Delresearch/WhisperTrack-Hardware/BOM/094-0098-00.xlsx

Part Number | Quantity | Reference Designator | Value | Description | AML Status | Manufacturer | Manufacturer Part
000-0000-00 | 25 | C25,C27,C53,C55,C75,D15,J5,J6,J7,J8,J9,J10,J11,R35,R46,R50,R52,R68,R77,R83,TP1,TP2,TP3,TP4,TP5 |  | DO NOT POPULATE
013-0143-00 | 2 | U5,U11 | SN74LVC2T45 | IC TRNSLTR BIDIRECTIONAL US8 | Preliminary | Texas Instruments | SN74LVC2T45DCUR
 |  |  |  |  | Preliminary | Texas Instruments | SN74LVC2T45DCUT
 |  |  |  |  | Preliminary | Nexperia USA Inc. | 74LVC2T45DC,125
013-0183-00 | 2 | U7,U14 | LMR36503MSCQRPERQ1 | AUTOMOTIVE 3-V TO 65-V, 0.3-A BU | Preliminary | Texas Instruments | LMR36503MSCQRPERQ1
013-0301-00 | 1 | U13 | SN74LVC2G86DCTR | IC GATE XOR 2CH 2-INP SM8 | Preliminary | Texas Instruments | SN74LVC2G86DCTR
013-0302-00 | 2 | U3,U4 | NCP51513ABMNTWG | 130V, 2.5/3.0A HIGH AND LOW SIDE | Preliminary | ON Semiconductor | NCP51513ABMNTWG
013-0305-00 | 1 | U18 | LM5156 | 2.2-MHZ WIDE VIN NONSYNCHRONOUS | Preliminary | Texas Instruments | LM5156DSSR
013-0319-00 | 1 | U17 | STM32L496VGT6P | IC MCU 32BIT 1MB FLASH 100LQFP | Preliminary | STMicroelectronics | STM32L496VGT6P
013-0320-00 | 1 | U12 | TPS7A20185PDBVR | IC REG LIN 1.85V 300MA SOT23-5 | Preliminary | Texas Instruments | TPS7A20185PDBVR
013-0322-00 | 1 | U9 | TLV709A50DBVR | 150-MA 30-V LOW-DROPOUT (LDO) LI | Preliminary | Texas Instruments | TLV709A50DBVR
013-0323-00 | 1 | U2 | TLV709A33DBVR | 150-MA 30-V LOW-DROPOUT (LDO) LI | Preliminary | Texas Instruments | TLV709A33DBVR
013-0326-00 | 1 | U19 | INA350CDSIDDFR | TINY (2-MM 2-MM), LOW-POWER (100 | Preliminary | Texas Instruments | INA350CDSIDDFR
013-0327-00 | 1 | Q6 | ZXMS6004N8-13 | IC PWR DRIVER N-CHANNEL 1:1 8SO | Preliminary | Diodes Incorporated | ZXMS6004N8-13
013-0360-00 | 1 | U6 | MCP6007 | IC OPAMP GP 2 CIRCUIT 8MSOP | Preliminary | Microchip Technology | MCP6007T-E/MS
 |  |  |  |  | Preliminary | Microchip Technology | MCP6007-E/MS
013-0361-00 | 1 | U10 | PS07-S160MP-6P | SENSOR 2320PSIS .15V | Preliminary | Same Sky | PS07-S160MP-6P
013-0362-00 | 1 | U1 | MCP3561RT-E/NC | IC ADC 24BIT SIGMA-DELTA 20UQFN | Preliminary | Microchip Technology | MCP3561RT-E/NC
013-0363-00 | 1 | U15 | TPS628437DRLR | IC REG BUCK PROG 600MA SOT563 | Preliminary | Texas Instruments | TPS628437DRLR
013-0364-00 | 1 | U16 | TPS22925CN | IC PWR SWITCH N-CHAN 1:1 6DSBGA | Preliminary | Texas Instruments | TPS22925CNYPHR
 |  |  |  |  | Preliminary | Texas Instruments | TPS22925CNYPHT
018-0001-00 | 7 | R1,R2,R4,R42,R54,R66,R69 | 10k/0402 | RES SMD 10K OHM 1% 1/16W 0402 | Preliminary | Yageo | RC0402FR-0710KL
 |  |  |  |  | Preliminary | Vishay Dale | CRCW040210K0FKED
018-0008-00 | 3 | R10,R11,R58 | 1k/0402 | RES SMD 1K OHM 1% 1/16W 0402 | Preliminary | Yageo | RC0402FR-071KL
 |  |  |  |  | Preliminary | Vishay Dale | CRCW04021K00FKED
018-0009-00 | 1 | R78 | 100/0402 | RES SMD 100 OHM 1% 1/16W 0402 | Preliminary | Yageo | RC0402FR-07100RL
 |  |  |  |  | Preliminary | Vishay Dale | CRCW0402100RFKED
018-0010-00 | 4 | R51,R53,R59,R60 | 33.2/0402 | RES SMD 33.2 OHM 1% 1/16W 0402 | Preliminary | Yageo | RC0402FR-0733R2L
 |  |  |  |  | Preliminary | Vishay Dale | CRCW040233R2FKED
018-0018-00 | 18 | R7,R39,R41,R43,R61,R63,R64,R67,R72,R75,R76,R79,R80,R82,R84,R95,R96,R98 | 0/0402 | RES SMD 0 OHM JUMPER 1/16W 0402 | Preliminary | Yageo | RC0402JR-070RL
 |  |  |  |  | Preliminary | Vishay Dale | CRCW04020000Z0ED
018-0020-00 | 18 | R5,R9,R12,R19,R23,R25,R34,R44,R45,R48,R49,R55,R56,R57,R65,R73,R94,R99 | 100k/0402 | RES SMD 100K OHM 1% 1/16W 0402 | Preliminary | Yageo | RC0402FR-07100KL
 |  |  |  |  | Preliminary | Vishay Dale | CRCW0402100KFKED
018-0041-00 | 1 | R97 | 10/0402 | RES SMD 10 OHM 1% 1/16W 0402 | Preliminary | Yageo | RC0402FR-0710RL
 |  |  |  |  | Preliminary | Panasonic Electronic Components | ERJ-2RKF10R0X
018-0043-00 | 1 | R47 | 11k/0402 | RES SMD 11K OHM 1% 1/16W 0402 | Preliminary | Yageo | RC0402FR-0711KL
 |  |  |  |  | Preliminary | Samsung Electro-Mechanics | RC1005F113CS
018-0094-00 | 1 | R85 | 59k/0402 | RES SMD 59K OHM 1% 1/16W 0402 | Preliminary | Stackpole Electronics Inc | RMCF0402FT59K0
 |  |  |  |  | Preliminary | Yageo | RC0402FR-0759KL
018-0100-00 | 1 | R81 | 5.11k/0402 | RES SMD 5.11K OHM 1% 1/16W 0402 | Preliminary | Yageo | RC0402FR-075K11L
 |  |  |  |  | Preliminary | Vishay Dale | CRCW04025K11FKEDC
018-0181-00 | 4 | R17,R21,R28,R32 | 22.1k/0603 | RES SMD 22.1K OHM 1% 1/10W 0603 | Preliminary | Stackpole Electronics Inc | RMCF0603FT22K1
 |  |  |  |  | Preliminary | Yageo | RC0603FR-0722K1L
018-0183-00 | 4 | R15,R20,R29,R30 | 0/0603 | RES SMD 0 OHM JUMPER 1/10W 0603 | Preliminary | Yageo | RC0603JR-070RP
 |  |  |  |  | Preliminary | Stackpole Electronics Inc | RMCF0603ZT0R00
018-0227-00 | 1 | R86 | 332k/0402 | RES SMD 332K OHM 1% 1/16W 0402 | Preliminary | Stackpole Electronics Inc | RMCF0402FT332K
 |  |  |  |  | Preliminary | Yageo | RC0402FR-07332KL
018-0256-00 | 2 | R90,R91 | 18.7k/0402 | RES SMD 18.7K OHM 1% 1/16W 0402 | Preliminary | Yageo | RC0402FR-0718K7L
 |  |  |  |  | Preliminary | Stackpole Electronics Inc | RMCF0402FT18K7
018-0264-00 | 1 | R88 | 21.5k/0402 | RES SMD 21.5K OHM 1% 1/16W 0402 | Preliminary | Stackpole Electronics Inc | RMCF0402FT21K5
 |  |  |  |  | Preliminary | Yageo | RC0402FR-0721K5L
018-0283-00 | 4 | R3,R8,R33,R89 | 221k/0402 | RES SMD 221K OHM 1% 1/16W 0402 | Preliminary | Yageo | RC0402FR-07221KL
 |  |  |  |  | Preliminary | Stackpole Electronics Inc | RMCF0402FT221K
018-0312-00 | 2 | R92,R100 | 200k/1206 | RES SMD 200K OHM 1% 1/4W 1206 | Preliminary | Yageo | RC1206FR-07200KL
 |  |  |  |  | Preliminary | Stackpole Electronics Inc | RMCF1206FT200K
018-0314-00 | 3 | R37,R40,R70 | 100k/0402/0.1% | RES SMD 100K OHM 0.1% 1/16W 0402 | Preliminary | Yageo | RT0402BRD07100KL
 |  |  |  |  | Preliminary | Panasonic Electronic Components | ERA-2AEB104X
018-0315-00 | 1 | R71 | 105k/0402/0.1% | RES SMD 105K OHM 0.1% 1/16W 0402 | Preliminary | Yageo | RT0402BRD07105KL
 |  |  |  |  | Preliminary | TE Connectivity Passive Product | CPF0402B105KE1
018-0316-00 | 1 | R62 | 0.018/2512 | RES 0.018 OHM 1% 3W 2512 | Preliminary | TE Connectivity Passive Product | TLRP3A30DR018FTE
 |  |  |  |  | Preliminary | Eaton - Electronics Division | MSMA2512R0180FGN
018-0317-00 | 1 | R87 | 9.53k/0402 | RES SMD 9.53K OHM 1% 1/16W 0402 | Preliminary | Yageo | RC0402FR-079K53L
 |  |  |  |  | Preliminary | Stackpole Electronics Inc | RMCF0402FT9K53
018-0320-00 | 2 | R93,R101 | 20k/1206/0.5W | RES 20K OHM 1% 1/2W 1206 | Preliminary | Stackpole Electronics Inc | RNCP1206FTD20K0
 |  |  |  |  | Preliminary | Vishay Dale | RCC120620K0FKEA
 |  |  |  |  | Preliminary | Vishay Dale | RCS120620K0FKEA
018-0334-00 | 1 | R36 | 12.4k/0402/0.1% | RES SMD 12.4KOHM 0.1% 1/16W 0402 | Preliminary | Panasonic Electronic Components | ERA-2AEB1242X
 |  |  |  |  | Preliminary | Susumu | RG1005P-1242-B-T5
018-0335-00 | 1 | R38 | 6.19k/0402/0.1% | RES SMD 6.19KOHM 0.1% 1/16W 0402 | Preliminary | Panasonic Electronic Components | ERA-2AEB6191X
 |  |  |  |  | Preliminary | Yageo | RT0402BRE076K19L
018-0336-00 | 4 | R16,R18,R26,R31 | 6.8/0603 | RES SMD 6.8 OHM 1% 1/10W 0603 | Preliminary | Yageo | RC0603FR-136R8L
 |  |  |  |  | Preliminary | Stackpole Electronics Inc | RMCF0603FT6R80
018-0337-00 | 6 | R6,R13,R14,R22,R24,R27 | 2/0603 | RES SMD 2 OHM 1% 1/10W 0603 | Preliminary | Yageo | RC0603FR-072RL
 |  |  |  |  | Preliminary | Stackpole Electronics Inc | RMCF0603FT2R00
018-0338-00 | 1 | R74 | 44.2k/0402 | RES SMD 44.2K OHM 1% 1/16W 0402 | Preliminary | Yageo | RC0402FR-0744K2L
 |  |  |  |  | Preliminary | Stackpole Electronics Inc | RMCF0402FT44K2
020-0002-00 | 5 | C4,C16,C31,C40,C47 | 0.1uF/50V/X7R/0603 | CAP CER 0.1UF 50V X7R 0603 | Preliminary | KEMET | C0603C104K5RACTU
 |  |  |  |  | Preliminary | Samsung Electro-Mechanics | CL10B104KB8NNNC
020-0008-00 | 2 | C9,C13 | 10uF/35V/X7R/1206 | CAP CER 10UF 35V X7R 1206 | Preliminary | Taiyo Yuden | GMK316AB7106KL-TR
 |  |  |  |  | Preliminary | TDK Corporation | CGA5L1X7R1V106K160AC
020-0012-00 | 1 | C34 | 4.7uF/16V/X7R/0805 | CAP CER 4.7UF 16V X7R 0805 | Preliminary | KEMET | C0805C475K4RACTU
 |  |  |  |  | Preliminary | Samsung Electro-Mechanics | CL21B475KOFNFNE
020-0013-00 | 1 | C67 | 100pF/50V/C0G/0402 | CAP CER 100PF 50V C0G/NP0 0402 | Preliminary | Murata Electronics | GRM1555C1H101JA01D
 |  |  |  |  | Preliminary | Samsung Electro-Mechanics | CL05C101JB5NNNC
020-0024-00 | 2 | C32,C41 | 10uF/50V/X5R/1206 | CAP CER 10UF 50V X5R 1206 | Preliminary | Taiyo Yuden | UMK316BBJ106ML-T
 |  |  |  |  | Preliminary | TDK Corporation | CGA5L3X5R1H106M160AB
020-0035-00 | 1 | C80 | 0.22uF/25V/X7R/0603 | CAP CER 0.22UF 25V X7R 0603 | Preliminary | KEMET | C0603C224K3RACAUTO
 |  |  |  |  | Preliminary | Würth Elektronik | 885012206073
020-0048-00 | 1 | C71 | 2.2uF/16V/X5R/0603 | CAP CER 2.2UF 16V X5R 0603 | Preliminary | Taiyo Yuden | EMK107ABJ225KAHT
 |  |  |  |  | Preliminary | Samsung Electro-Mechanics | CL10A225KO8NNNC
020-0057-00 | 5 | C21,C23,C56,C70,C83 | 1000pF/50V/C0G/0402/1% | CAP CER 1000PF 50V C0G/NP0 0402 | Preliminary | Murata Electronics | GRM1555C1H102FA01D
 |  |  |  |  | Preliminary | Murata Electronics | GRM1555C1H102FA01J
020-0074-00 | 29 | C1,C2,C3,C7,C8,C10,C18,C19,C22,C24,C30,C33,C35,C36,C37,C43,C46,C51,C57,C59,C65,C74,C76,C79,C81,C84,C85,C87,C88 | 0.1uF/25V/X7R/0402 | CAP CER 0.1UF 25V X7R 0402 | Preliminary | Murata Electronics | GRM155R71E104KE14J
 |  |  |  |  | Preliminary | Yageo | CC0402KRX7R8BB104
020-0075-00 | 3 | C12,C17,C48 | 0.1uF/100V/X7R/0603 | CAP CER 0.1UF 100V X7R 0603 | Preliminary | Samsung Electro-Mechanics | CL10B104KC8NNNC
 |  |  |  |  | Preliminary | Yageo | CC0603KRX7R0BB104
020-0077-00 | 4 | C14,C15,C38,C39 | 2.2uF/100V/X7R/1210 | CAP CER 2.2UF 100V X7R 1210 | Preliminary | Samsung Electro-Mechanics | CL32B225KCJSNNE
 |  |  |  |  | Preliminary | Taiyo Yuden | HMK325B7225KM-P
020-0083-00 | 3 | C54,C58,C78 | 4.7uF/6.3V/X5R/0402 | CAP CER 4.7UF 6.3V X5R 0402 | Preliminary | Samsung Electro-Mechanics | CL05A475KQ5NRNC
 |  |  |  |  | Preliminary | Yageo | CC0402KRX5R5BB475
020-0101-00 | 1 | C42 | 22uF/6.3V/X5R/0402 | CAP CER 22UF 6.3V X5R 0402 | Preliminary | Samsung Electro-Mechanics | CL05A226MQ5N6J8
 |  |  |  |  | Preliminary | Venkel | C0402X5R6R3-226MNP
020-0111-00 | 2 | C11,C20 | 1000pF/2kV/X7R/1206 | CAP CER 1000PF 2KV X7R 1206 | Preliminary | KEMET | C1206C102KGRACTU
 |  |  |  |  | Preliminary | Johanson Dielectrics Inc. | 202R18W102KV4E
020-0112-00 | 1 | C69 | 1500pF/50V/C0G/0603 | CAP CER 1500PF 50V C0G/NP0 0603 | Preliminary | Murata Electronics | GRM1885C1H152JA01D
 |  |  |  |  | Preliminary | Samsung Electro-Mechanics | CL10C152JB8NNNC
020-0126-00 | 2 | C44,C45 | 10uF/63V/X7R/1210 | CAP CER 10UF 63V X7R 1210 | Preliminary | Samsung Electro-Mechanics | CL32B106KMVNNWE
020-0135-00 | 1 | C60 | 10uF/6.3V/X5R/0402 | CAP CER 10UF 6.3V X5R 0402 | Preliminary | Murata Electronics | GRM155R60J106ME15D
 |  |  |  |  | Preliminary | Samsung Electro-Mechanics | CL05A106MQ5NUNC
020-0145-00 | 11 | C6,C26,C28,C29,C49,C50,C52,C61,C62,C64,C66 | 1uF/10V/X7R/0402 | CAP CER 1UF 10V X7R 0402 | Preliminary | Murata Electronics | GRM155Z71A105KE01J
 |  |  |  |  | Preliminary | Murata Electronics | GRM155Z71A105KE01D
020-0160-00 | 2 | C5,C63 | 10000pF/25V/C0G/0402 | CAP CER 10000PF 25V C0G/NP0 0402 | Preliminary | Murata Electronics | GRM1555C1E103GE01D
 |  |  |  |  | Preliminary | Murata Electronics | GRM1555C1E103JE01J
 |  |  |  |  | Preliminary | Murata Electronics | GRM1555C1E103JE01D
020-0162-00 | 1 | C68 | 0.033uF/50V/C0G/0805 | CAP CER 0.033UF 50V C0G/NP0 0805 | Preliminary | Murata Electronics | GRM2165C1H333JA01J
 |  |  |  |  | Preliminary | TDK Corporation | C2012C0G1H333J125AA
020-0171-00 | 1 | C72 | 10000pF/100V/X7R/0603 | CAP CER 10000PF 100V X7R 0603 | Preliminary | Murata Electronics | GCM188R72A103KA37D
 |  |  |  |  | Preliminary | KEMET | C0603C103K1RAC7867
020-0176-00 | 2 | C73,C77 | 3.9pF/50V/C0G/0402 | CAP CER 3.9PF 50V C0G/NP0 0402 | Preliminary | Murata Electronics | GJM1555C1H3R9CB01D
 |  |  |  |  | Preliminary | Yageo | CC0402CRNPO9BN3R9
020-0178-00 | 2 | C82,C90 | 430pF/500V/C0G/0805 | CAP CER 430PF 500V C0G/NP0 0805 | Preliminary | KEMET | C0805C431JCGAC7800
 |  |  |  |  | Preliminary | KEMET | C0805C431JCGACAUTO
020-0179-00 | 2 | C86,C89 | 43pF/1kV/C0G/0805 | CAP CER 43PF 1KV C0G/NP0 0805 | Preliminary | Johanson Technology Inc. | QCCT102Q430J1GV001E
022-0010-00 | 3 | Q3,Q10,Q12 | 50V/0.18A | MOSFET P-CH 50V TO-236AB | Preliminary | Nexperia USA Inc. | BSS84AK,215
022-0012-00 | 7 | Q1,Q2,Q8,Q11,Q13,Q14,Q16 | 50V/0.22A | MOSFET N-CH 50V 220MA SOT-23-3 | Preliminary | ON Semiconductor | BSS138K
 |  |  |  |  | Preliminary | ON Semiconductor | BVSS138LT1G
 |  |  |  |  | Preliminary | Rohm Semiconductor | RUC002N05T116
 |  |  |  |  | Preliminary | Micro Commercial Co | BSS138-TP
022-0028-00 | 4 | Q4,Q5,Q7,Q9 | 100V/17A | N-CHANNEL 100 V, 40 MOHM, STANDA | Preliminary | Nexperia USA Inc. | PXN040-100QSJ
022-0032-00 | 1 | Q15 | 100V/44A | MOSFET N-CH 100V 44A TDSON-8-6 | Preliminary | Infineon Technologies | BSC146N10LS5ATMA1
023-0006-00 | 1 | U8 | 2.048MHz, +-100ppm | OSC MEMS 2.0480MHZ LVCMOS SMD | Preliminary | SiTIME | SIT8021AI-J4-18S-2.048000E
 |  |  |  |  | Preliminary | SiTIME | SIT8021AI-J4-18S-2.048000
 |  |  |  |  | Preliminary | SiTIME | SIT8021AI-J4-18S-2.048000D
 |  |  |  |  | Preliminary | SiTIME | SIT8021AI-J4-18S-2.048000S
023-0033-00 | 1 | Y1 | 32.768kHz +- 10ppm | CRYSTAL 32.7680KHZ 6PF SMD | Preliminary | Abracon LLC | ABS06-32.768KHZ-6-1-T
 |  |  |  |  | Preliminary | ECS Inc. | ECS-.327-6-12-C-TR
024-0008-00 | 2 | D1,D7 | 100V/1A | DIODE GEN PURP 100V 1A SMA | Preliminary | Diodes Incorporated | S1B-13-F
024-0010-00 | 1 | D14 | LED, Red | LED RED CLEAR 0603 SMD | Preliminary | Lite-On Inc. | LTST-C191KRKT
 |  |  |  |  | Preliminary | Lite-On Inc. | LTST-C190KRKT
024-0017-00 | 5 | D4,D17,D18,D19,D20 | 75V/0.15A | DIODE GEN PURP 75V 150MA SOD323 | Preliminary | Micro Commercial Co | 1N4148WX-TP
 |  |  |  |  | Preliminary | Comchip Technology | 1N4148WS-HF
 |  |  |  |  | Preliminary | Diodes Incorporated | BAV16WS-7-F
024-0025-00 | 1 | D13 | LED, Green | LED GREEN DIFFUSED 0603 SMD | Preliminary | Würth Elektronik | 150060VS55040
024-0029-00 | 4 | D2,D3,D10,D11 | 40V/1A | DIODE SCHOTTKY 40V 1A POWERDI323 | Preliminary | Diodes Incorporated | PD3S140-7
024-0054-00 | 6 | D5,D6,D8,D9,D12,D16 | 100V/5A | DIODE SCHOTTKY 100V 5A DO214AC | Preliminary | Micro Commercial Co | SK510A-LTP
026-0031-00 | 1 | L6 | 1uH/3.1A | FIXED IND 1UH 3.1A 45 MOHM SMD | Preliminary | Taiyo Yuden | MAMK2520H1R0M
026-0041-00 | 1 | L4 | 22uH/0.29A | FIXED IND 22UH 290MA 2.52 OHM | Preliminary | Murata Electronics | LQH2MPN220MGRL
 |  |  |  |  | Preliminary | Murata Electronics | LQH2MPZ220MGRL
026-0074-00 | 1 | L3 | 47uH/0.44A | FIXED IND 47UH 440MA 780MOHM SMD | Preliminary | Taiyo Yuden | LSXND4040TKL470MDG
 |  |  |  |  | Preliminary | Bourns Inc. | SRN4018BTA-470M
 |  |  |  |  | Preliminary | Taiyo Yuden | NRS4018T470MDGJ
 |  |  |  |  | Preliminary | Taiyo Yuden | NRS4018T470MDGJV
026-0096-00 | 2 | L1,L2 | 470uH/1.4A | FIXED IND 470UH 1.4A 560MOHM SMD | Preliminary | Würth Elektronik | 7447709471
 |  |  |  |  | Preliminary | CODACA | SPRH1210-471M
026-0097-00 | 1 | L5 | 22uH/7.5A | IND SMD 22UH 7.5A | Preliminary | Bourns Inc. | SRP1245CC-220M
028-0130-00 | 4 | J1,J2,J3,J4 | 122TR | BATT CONTACT SOLID MULTIPLE SMD | Preliminary | Keystone Electronics | 122TR
