Delresearch/WhisperTrack-Hardware/Schematic/001-0098-00.pdf

# VIN=12-42V, VOUT=1.95V, IOUT=300mA, Sequence #0

# Power Entry

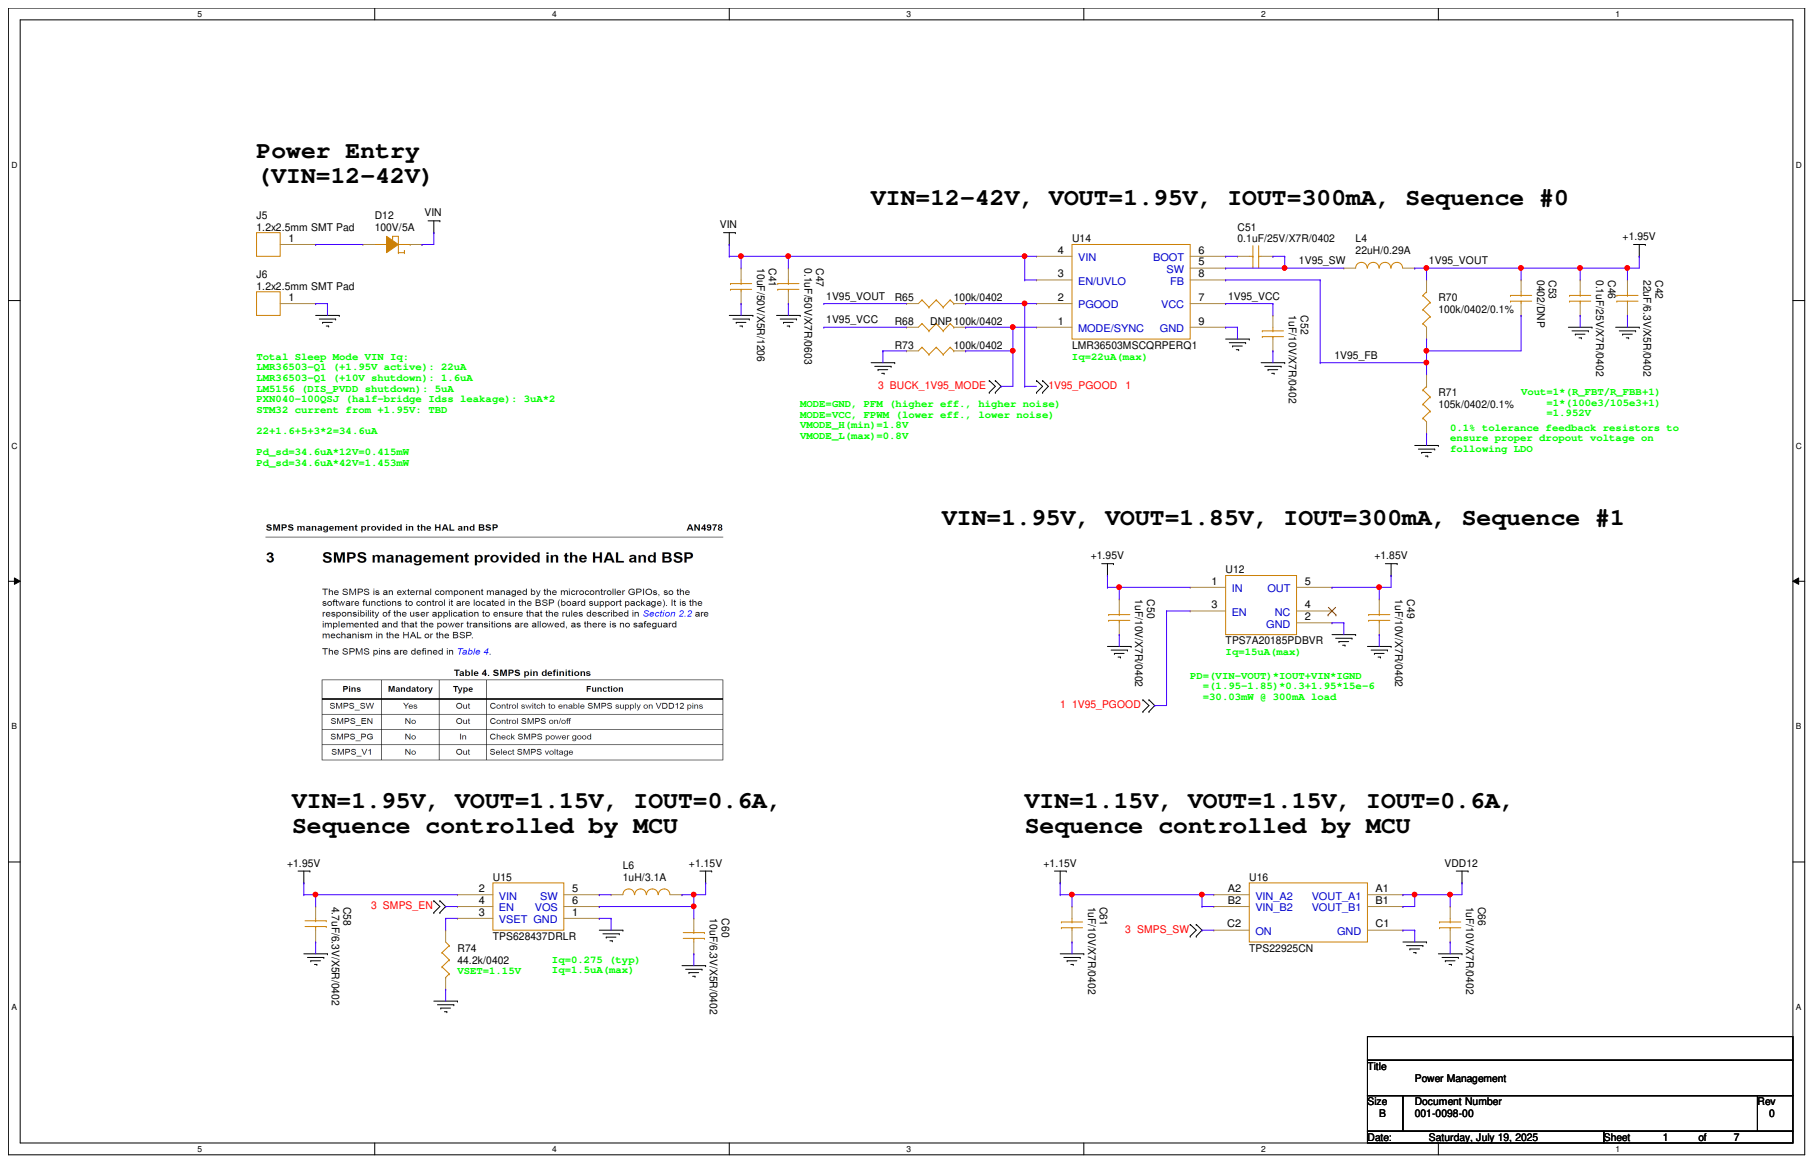
[picture p1: page 1]

Total Sleep Mode VIN Iq:
LMR36503-Q1 (+1.95V active): 22uA
LMR36503-Q1 (+10V shutdown): 1.6uA
LM5156 (DIS_PVDD shutdown): 5uA
PXN040-100QSJ (half-bridge Idss leakage): 3uA*2
STM32 current from +1.95V: TBD

MODE=GND, PFM (higher eff., higher noise)
MODE=VCC, FPWM (lower eff., lower noise)
VMODE_H(min)=1.8V
VMODE_L(max)=0.8V

0.1% tolerance feedback resistors to
ensure proper dropout voltage on
following LDO

VIN=1.95V, VOUT=1.85V, IOUT=300mA, Sequence #1

PD=(VIN-VOUT)*IOUT+VIN*IGND
=30.03mW @ 300mA load

VIN=1.95V, VOUT=1.15V, IOUT=0.6A,
Sequence controlled by MCU

VIN=1.15V, VOUT=1.15V, IOUT=0.6A,

VIN=12-42V, VOUT=10V, IOUT=300mA,

# Sequence controlled by MCU

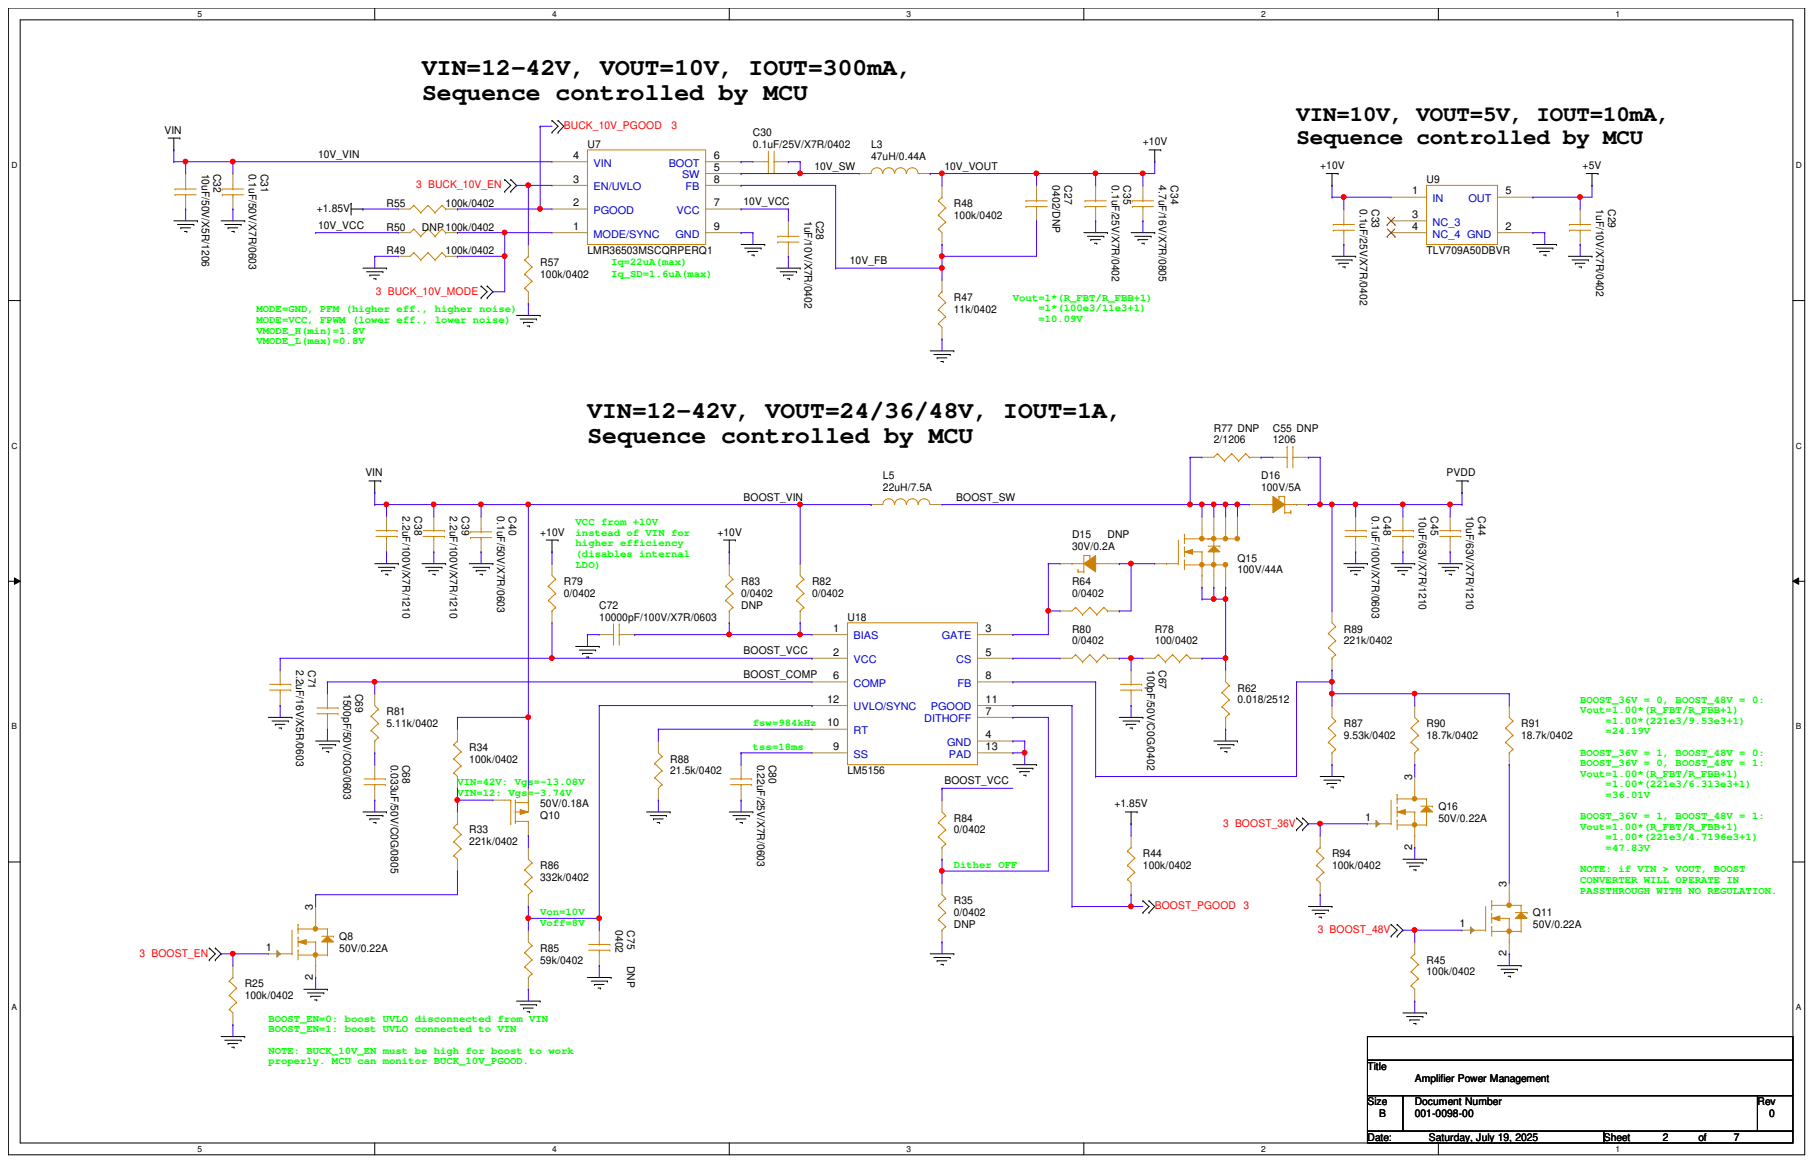
[picture p2: page 2]
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

VIN=12-42V, VOUT=24/36/48V, IOUT=1A,
Sequence controlled by MCU

NOTE: if VIN > VOUT, BOOST
CONVERTER WILL OPERATE IN
PASSTHROUGH WITH NO REGULATION.

BOOST_EN=0: boost UVLO disconnected from VIN
BOOST_EN=1: boost UVLO connected to VIN

NOTE: BUCK_10V_EN must be high for boost to work
properly. MCU can monitor BUCK_10V_PGOOD.

# MCU Signal

# MCU Power

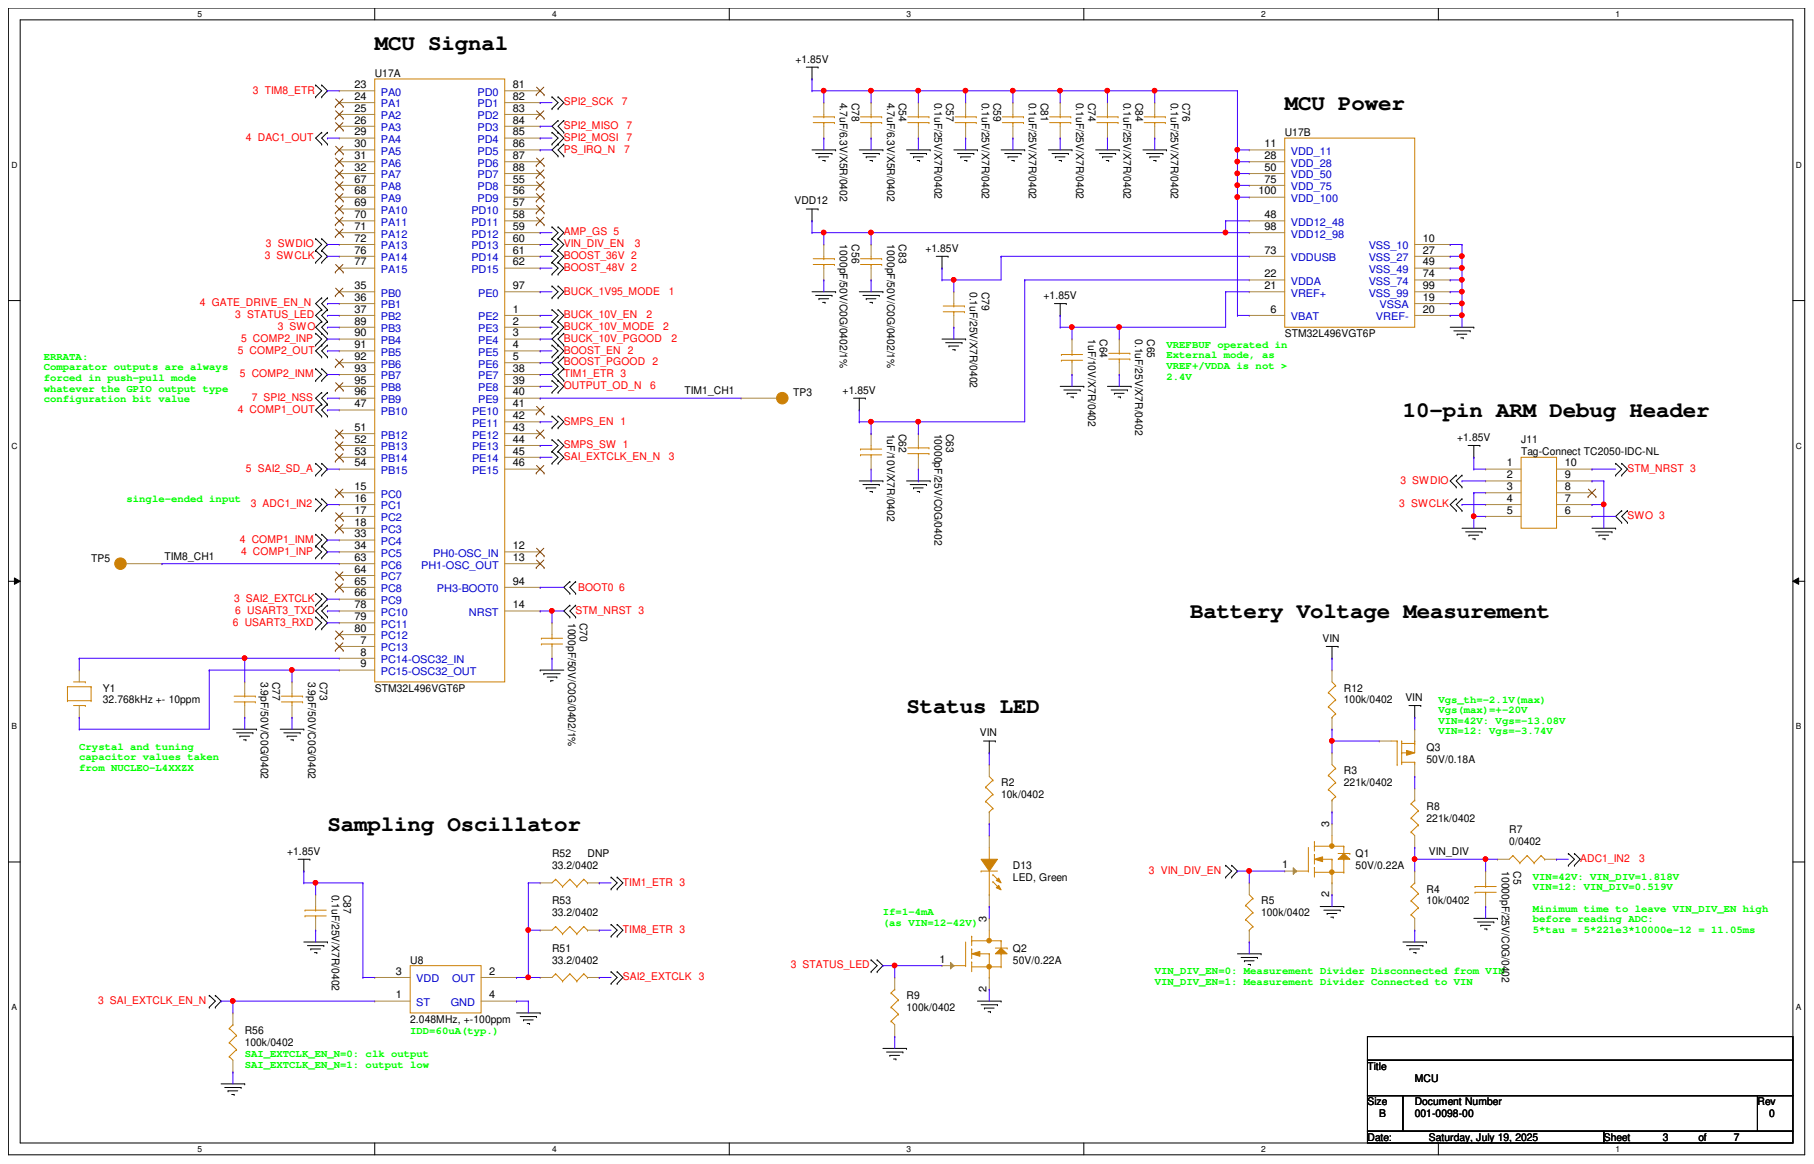
[picture p3: page 3]

VREFBUF operated in
External mode, as
VREF+/VDDA is not >

ERRATA:
Comparator outputs are always
forced in push-pull mode
whatever the GPIO output type

C63J11 Tag-Connect TC2050-IDC-NL

Minimum time to leave VIN_DIV_EN high
before reading ADC:
5*tau = 5*221e3*10000e-12 = 11.05ms

VIN_DIV_EN=0: Measurement Divider Disconnected from VIN
VIN_DIV_EN=1: Measurement Divider Connected to VIN

## Gate Driver Enable Level Translator

## Half-Bridge Gate Driver

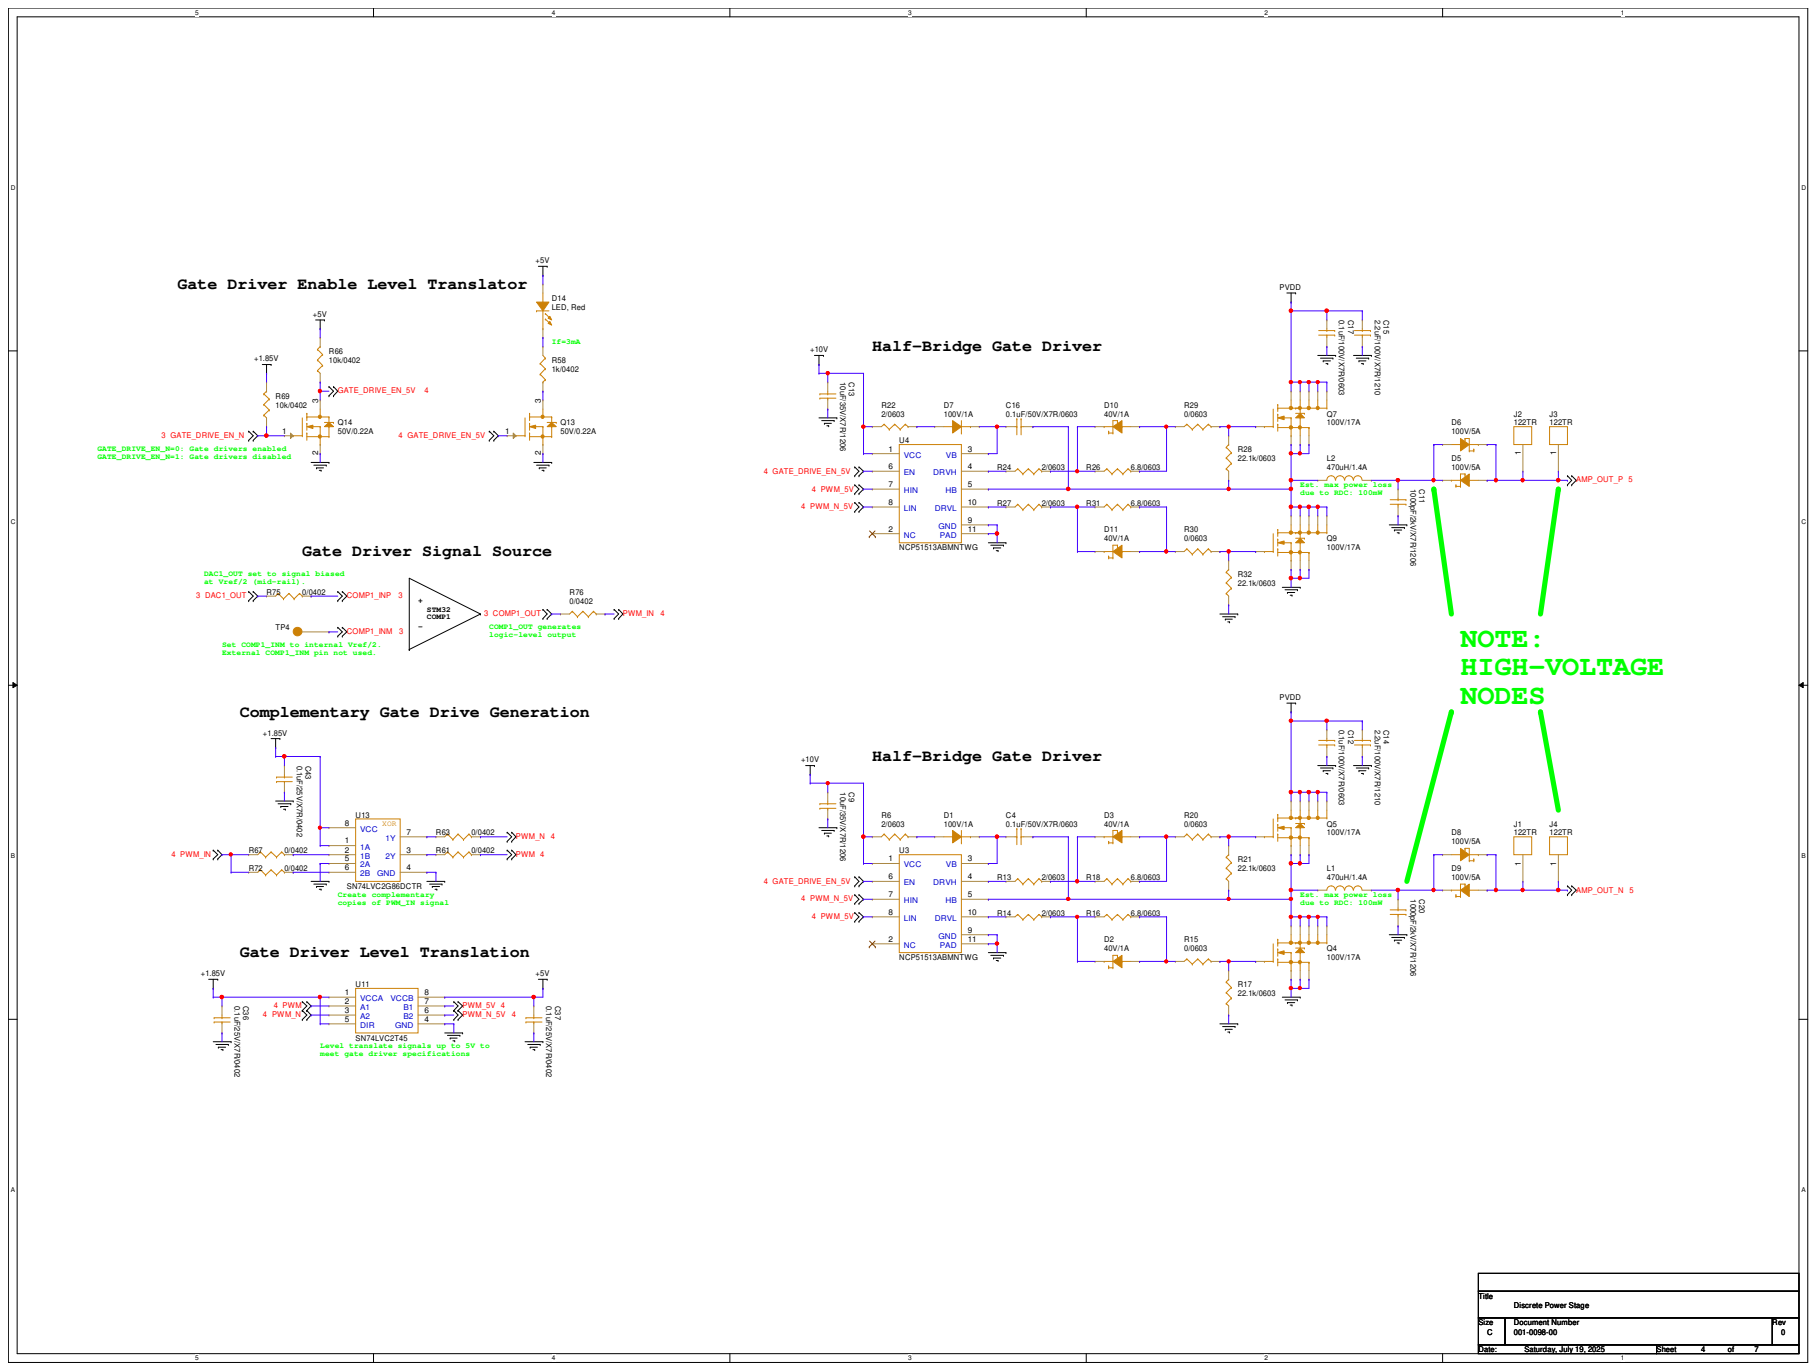
[picture p4: page 4]

Est. max power loss
due to RDC: 100mW

Gate Driver Signal Source

DAC1_OUT set to signal biased
at Vref/2 (mid-rail).

Set COMP1_INM to internal Vref/2.
External COMP1_INM pin not used.

Complementary Gate Drive Generation

Half-Bridge Gate Driver

Gate Driver Level Translation

Level translate signals up to 5V to
meet gate driver specifications

# Transducer HPF & TR Clamp

### RX Connection Explanation:

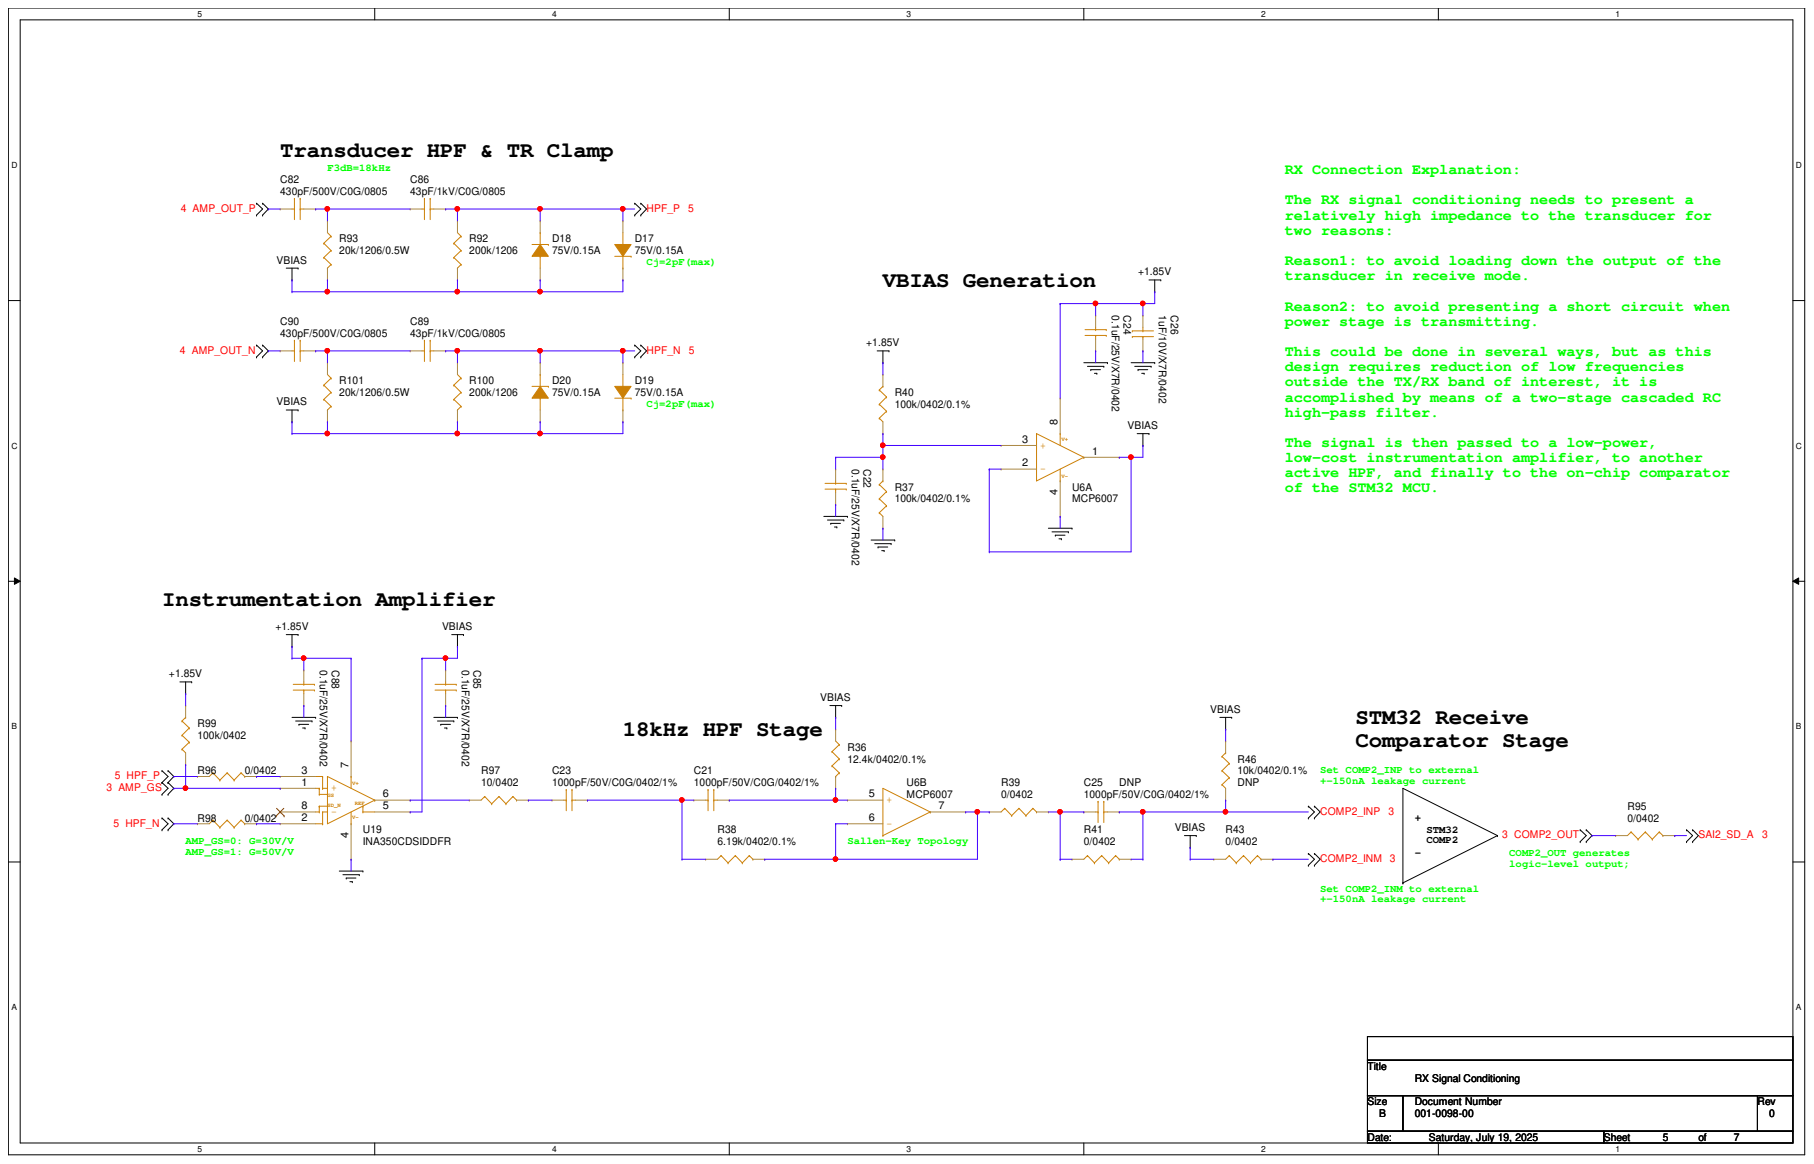
[picture p5: page 5]

The RX signal conditioning needs to present a
relatively high impedance to the transducer for
two reasons:

Reason1: to avoid loading down the output of the
transducer in receive mode.

Reason2: to avoid presenting a short circuit when
power stage is transmitting.

This could be done in several ways, but as this
design requires reduction of low frequencies
outside the TX/RX band of interest, it is
accomplished by means of a two-stage cascaded RC
high-pass filter.

The signal is then passed to a low-power,
low-cost instrumentation amplifier, to another
active HPF, and finally to the on-chip comparator
of the STM32 MCU.

D | D

## BOOT0=0 / BOOT0_N=1: Flash Boot

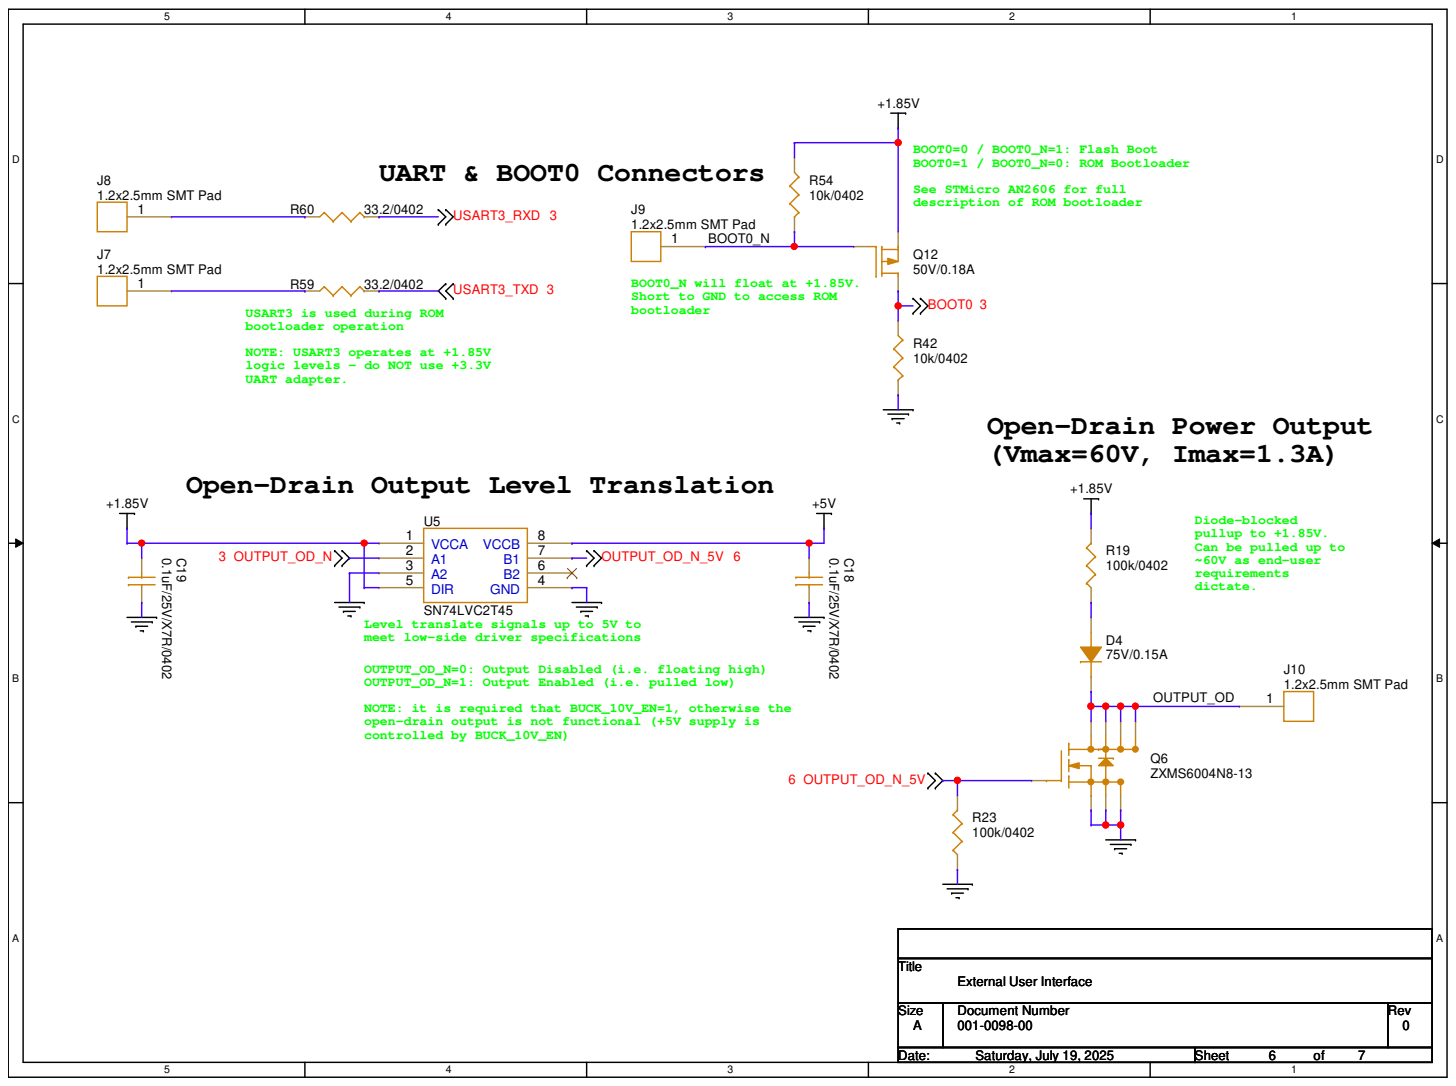
[picture p6: page 6]

See STMicro AN2606 for full
description of ROM bootloader

BOOT0_N will float at +1.85V.
Short to GND to access ROM
bootloader

USART3 is used during ROM
bootloader operation

NOTE: USART3 operates at +1.85V
logic levels - do NOT use +3.3V
UART adapter.

Open-Drain Power Output
(Vmax=60V, Imax=1.3A)

Open-Drain Output Level Translation

Diode-blocked
pullup to +1.85V.
Can be pulled up to
~60V as end-user
requirements
dictate.

Level translate signals up to 5V to
meet low-side driver specifications

OUTPUT_OD_N=0: Output Disabled (i.e. floating high)
OUTPUT_OD_N=1: Output Enabled (i.e. pulled low)

NOTE: it is required that BUCK_10V_EN=1, otherwise the
open-drain output is not functional (+5V supply is
controlled by BUCK_10V_EN)

D | D
VIN=10V, VOUT=3.3V, IOUT=10mA,

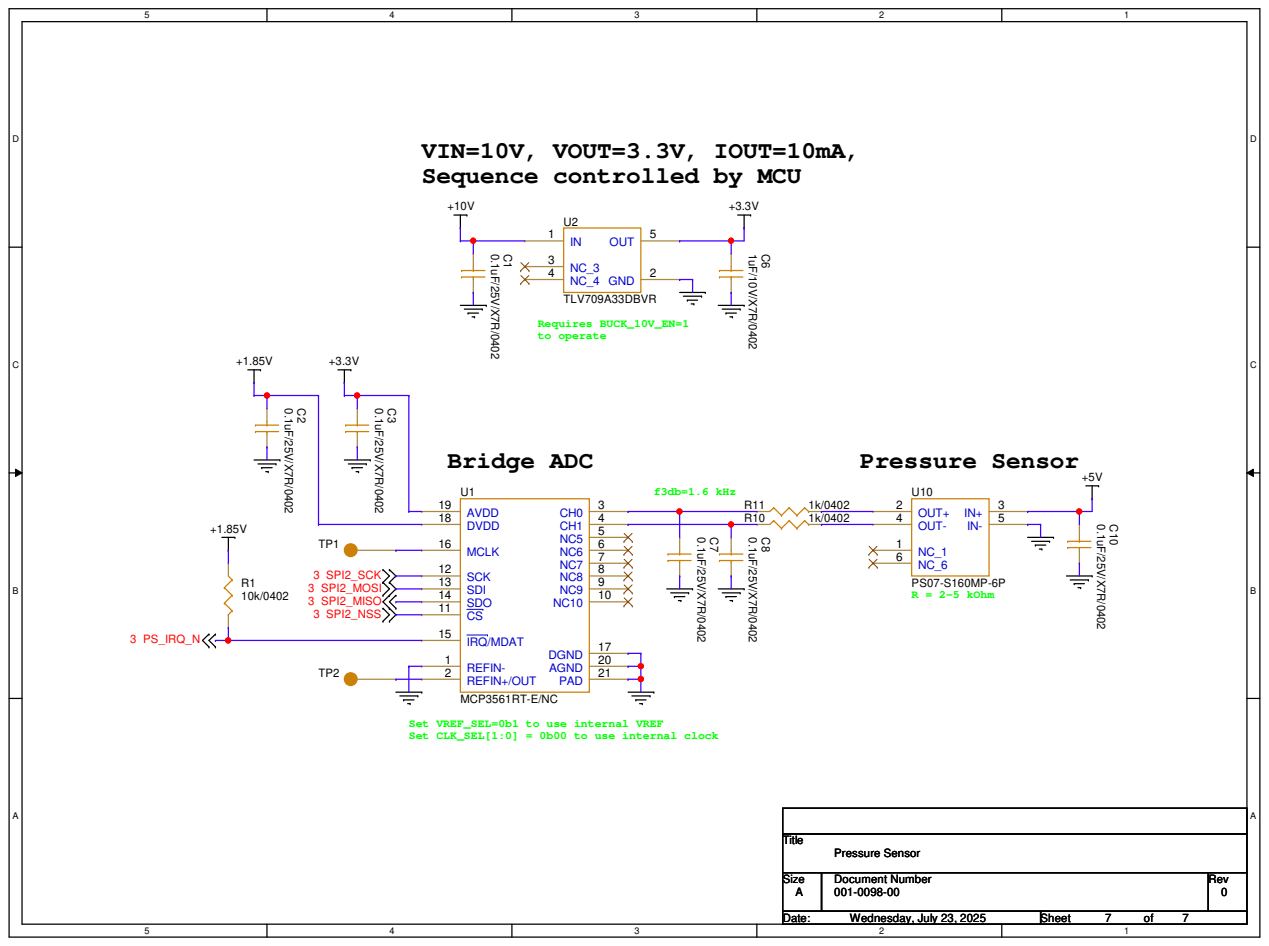
[picture p7: page 7]

Sequence controlled by MCU

Set VREF_SEL=0b1 to use internal VREF
Set CLK_SEL[1:0] = 0b00 to use internal clock
