Delresearch/WhisperTrack-Hardware/(list of files, drawings)

Other design files:
Schematic/001-0098-00.DSN
